KULeuven-MICAS/lagd-im/hw/rtl/analog_macro_wrap/CHANGELOG.md

## 0.1.0 - 2026-1-7
- Initial release of RTL and a testbench.

## 0.1.1 - 2026-1-12
- Add convertion for J/h from 2's complemented format to specific format (can be turn off).
- Remove signal *synchronizer_mode_i* as it is not useful.
- Add signal *wbl_floating_o* and *spin_feedback_o* which are newly required by the analog macro.
- Spread spin output to the analog macro in WBL. Its location is configued by a new parameter *SPIN_WBL_OFFSET*.
- Move the synchronization starting timing to be one cycle earlier.
- Add isolation AND gate in analog_tx if SYN=1.

## 0.1.2 - 2026-1-27
- Add debugging submodules for testing J/h writing/reading and spin writing/computing/reading.
- Add wwl_vdd_i and wwl_vread_i as new configurable parameters.
- Add debug_dt_configure_enable_i and debug_spin_configure_enable_i as new configuration enable signals for debug-related submodules.
- Add standard synchronization cells in analog_tx if SYN=1.
