KULeuven-MICAS/lagd-im/hw/rtl/digital_macro/CHANGELOG.md

## 0.1.0 - 2026-1-12
- Initial release of RTL and a testbench.
