KULeuven-MICAS/lagd-im/hw/rtl/flip_manager/CHANGELOG.md

## 0.1.0 - 2025-12-2
- Initial release of RTL and a testbench.
- The latency is 3 cycles.
- Configurability: depth of the spin fifo can be changed.
