KULeuven-MICAS/lagd-im/hw/tb/models/galena/galena.sv

// Copyright 2025 KU Leuven.
// Licensed under the Apache License, Version 2.0, see LICENSE for details.
// SPDX-License-Identifier: Apache-2.0
//
// Author: Jiacong Sun <jiacong.sun@kuleuven.be>

// Behavior model for galena

`timescale 1ns / 1ps

`ifndef PROJECT_ROOT
`define PROJECT_ROOT "../../"
`endif

`ifndef STATE_OUT_FILE_1
`define STATE_OUT_FILE_1 {`PROJECT_ROOT, "sw/tests/data/default/states_out_1"} // relative to hw/tb/
`endif

`ifndef STATE_OUT_FILE_2
`define STATE_OUT_FILE_2 {`PROJECT_ROOT, "sw/tests/data/default/states_out_2"} // relative to hw/tb/
`endif

`ifndef VERBOSE
`define VERBOSE 0
`endif

import galena_pkg::*;

`include "lagd_platform.svh"

module galena #(
) (

    // --- Analog pins ----
    inout j_vup_aio  ,  // not used in the behavior model, but included for completeness
    inout j_vdn_aio  ,  // not used in the behavior model, but included for completeness
    inout h_vup_aio  ,  // not used in the behavior model, but included for completeness
    inout h_vdn_aio  ,  // not used in the behavior model, but included for completeness
    inout vread_aio  ,  // not used in the behavior model, but included for completeness

    // --- Digital pins ---
    input [WBL_WIDTH-1:0] wbl_i,
    input [WBL_WIDTH-1:0] wblb_i, // not used in the behavior model, but included for completeness
    input [WBL_WIDTH-1:0] wbl_floating_i,

    input [WWL_WIDTH-1:0] wwl_i,
    input [WWL_WIDTH-1:0] wwl_vdd_i,
    input [WWL_WIDTH-1:0] wwl_vread_i,

    input [NUM_SPIN-1:0] write_spin_i,
    input [NUM_SPIN-1:0] feedback_i,

    output logic [WBL_WIDTH-1:0] wbl_read_o,
    output logic [WBL_WIDTH-1:0] wblb_read_o,
    output logic [NUM_SPIN-1:0] bct_read_o
);
    // Internal signals
    logic [WWL_WIDTH-1:0] [WBL_WIDTH-1:0] data_array;
    logic [NUM_SPIN-1:0] spin_cache;
    logic [SPIN_ICON_DEPTH-1:0] [NUM_SPIN-1:0] state_out;
    logic [$clog2(SPIN_ICON_DEPTH)-1:0] j = 0;
    real spin_delay = 0;

    // ========================================================================
    // BEHAVIOR MODEL
    // ========================================================================
    assign wblb_read_o = ~wbl_read_o;

    // Data writing
    generate
        for (genvar i = 0; i < WWL_WIDTH; i++) begin: data_writing
            always_ff @(posedge wwl_i[i]) begin
                if (wbl_floating_i == {WBL_WIDTH{1'b1}}) begin
                    data_array[i] <= wbl_i;
                    if (`VERBOSE) begin
                        $info("[Time: %0t] Data is written to data_array[%0d]: 'h%h", $time, i, wbl_i);
                    end
                end
            end
        end
    endgenerate

    // Data reading
    always_comb begin
        wbl_read_o = {WBL_WIDTH{1'bx}};
        for (int i = 0; i < WWL_WIDTH; i++) begin
            if (wwl_i[i]) begin
                if (wbl_floating_i == {WBL_WIDTH{1'b0}}) begin
                    wbl_read_o = data_array[i];
                end else begin
                    wbl_read_o = {WBL_WIDTH{1'bx}};
                end
            end
        end
    end

    // Spin intenal cache behavior
    generate
        if (DATA_FROM_FILE) begin
            // The state files are selected at run time, per core: this instance derives its core
            // index from its own hierarchical path (the gen_cores loop index in lagd_soc), so the
            // RTL instantiation stays identical to the real macro.
            // Priority: +CORE<n>_STATE_OUT_FILE_x, then +STATE_OUT_FILE_x, then `STATE_OUT_FILE_x.
            int core_id;
            string state_out_file_1;
            string state_out_file_2;
            initial begin
                core_id = hier_loop_index($sformatf("%m"));
                state_out_file_1 = `STATE_OUT_FILE_1;
                state_out_file_2 = `STATE_OUT_FILE_2;
                void'($value$plusargs("STATE_OUT_FILE_1=%s", state_out_file_1));
                void'($value$plusargs("STATE_OUT_FILE_2=%s", state_out_file_2));
                void'($value$plusargs($sformatf("CORE%0d_STATE_OUT_FILE_1=%%s", core_id),
                                      state_out_file_1));
                void'($value$plusargs($sformatf("CORE%0d_STATE_OUT_FILE_2=%%s", core_id),
                                      state_out_file_2));
                $display("[Time: %0t] %m is the analog macro of core %0d", $time, core_id);
                state_out = load_state_out_ref(state_out_file_1, state_out_file_2);
            end
            always_ff @(posedge &write_spin_i) begin // the behavior model assumes write_spin_i is all-one or all-zero
                spin_cache <= state_out[j];
                if (`VERBOSE) begin
                    $info("[Time: %0t] Spin initial cache is updated from state_out[%0d]: 'h%h", $time, j, state_out[j]);
                end
                j <= (j + 1) % SPIN_ICON_DEPTH;
            end
        end else begin
            always_ff @(posedge &write_spin_i) begin // the behavior model assumes write_spin_i is all-one or all-zero
                for (int i = 0; i < NUM_SPIN; i++) begin
                    spin_cache[i] <= wbl_i[BIT_DATA*i + SPIN_WBL_OFFSET];
                end
                if (`VERBOSE) begin
                    $info("[Time: %0t] Spin internal cache is updated from wbl_i: 'h%h", $time, wbl_i);
                end
            end
        end
    endgenerate

    // Spin readout behavior
    generate
        for (genvar i = 0; i < NUM_SPIN; i++) begin: spin_readout
            initial begin
                forever begin
                    @(posedge feedback_i[i]); // Wait for rising edge of feedback_i[i]
                    spin_delay = $urandom_range(SPIN_DELAY_MIN*1000, SPIN_DELAY_MAX*1000) / 1000.0; // random delay
                    #spin_delay;
                    bct_read_o[i] = spin_cache[i];
                    @(negedge feedback_i[i]); // Wait for falling edge of feedback_i[i]
                    bct_read_o[i] = 1'bx;
                end
            end
        end
    endgenerate

    // ========================================================================
    // CHECKS
    // ========================================================================
`ifndef TARGET_GALENA_NO_CHECKS
    `RUNTIME_ASSERT($time == 0 || $onehot0(wwl_i), $sformatf("wwl_i is not one-hot: 'h%h", wwl_i));

    // all-zero/one check on wbl_floating_i, wwl_vdd_i, wwl_vread_i, write_spin_i, feedback_i
    `RUNTIME_ASSERT($time == 0 || wbl_floating_i == 0 || wbl_floating_i == {WBL_WIDTH{1'b1}}, $sformatf("wbl_floating_i is not all-zero or all-one: 'h%h", wbl_floating_i));
    `RUNTIME_ASSERT($time == 0 || wwl_vdd_i      == 0 || wwl_vdd_i      == {WWL_WIDTH{1'b1}}, $sformatf("wwl_vdd_i is not all-zero or all-one: 'h%h",           wwl_vdd_i));
    `RUNTIME_ASSERT($time == 0 || wwl_vread_i    == 0 || wwl_vread_i    == {WWL_WIDTH{1'b1}}, $sformatf("wwl_vread_i is not all-zero or all-one: 'h%h",       wwl_vread_i));
    `RUNTIME_ASSERT($time == 0 || write_spin_i   == 0 || write_spin_i   == {NUM_SPIN {1'b1}}, $sformatf("write_spin_i is not all-zero or all-one: 'h%h",     write_spin_i));
    `RUNTIME_ASSERT($time == 0 || feedback_i     == 0 || feedback_i     == {NUM_SPIN {1'b1}}, $sformatf("feedback_i is not all-zero or all-one: 'h%h",         feedback_i));

    // check: wwl_vdd_i and wwl_vread_i cannot be both 1
    `RUNTIME_ASSERT($time == 0 || (wwl_vdd_i & wwl_vread_i) == 0, $sformatf("wwl_vdd_i and wwl_vread_i cannot be both 1: wwl_vdd_i: 'h%h, wwl_vread_i: 'h%h", wwl_vdd_i, wwl_vread_i));

    // check: wwl_i and write_spin_i cannot be both 1
    `RUNTIME_ASSERT($time == 0 || ($countones(wwl_i) == 0) || ($countones(write_spin_i) == 0), $sformatf("wwl_i and write_spin_i cannot be both 1: wwl_i: 'h%h, write_spin_i: 'h%h", wwl_i, write_spin_i));
`endif

endmodule
