KULeuven-MICAS/lagd-im/hw/rtl/flip_manager/flip_manager.sv

// Copyright 2025 KU Leuven.
// Licensed under the Apache License, Version 2.0, see LICENSE for details.
// SPDX-License-Identifier: Apache-2.0

// Author: Jiacong Sun <jiacong.sun@kuleuven.be>
//
// Flip manager
// Manages spin configuration, buffering, energy-maintenance and flip engine interface.
// Coordinates three sub-modules: energy_fifo_maintainer, spin_fifo_maintainer and flip_engine.
//
// Parameters:
// - NUM_SPIN: width of a spin vector (number of spins per word)
// - SPIN_DEPTH: depth (entries) of internal spin FIFOs
// - ENERGY_TOTAL_BIT: bit-width of the total energy value
// - FLIP_ICON_DEPTH: depth of flip icon memory
// - FLIP_ICON_ADDR_DEPTH: address width for flip icon memory (usually $clog2(FLIP_ICON_DEPTH))
//
// Notes:
// - This module arbitrates between configuration-driven pushes and energy-driven pushes into the spin FIFO.

`include "common_cells/registers.svh"

module flip_manager #(
    parameter int NUM_SPIN = 256,
    parameter int SPIN_DEPTH = 2,
    parameter int ENERGY_TOTAL_BIT = 32,
    parameter int FLIP_ICON_DEPTH = 1024,
    // Do not override
    parameter int FLIP_ICON_ADDR_DEPTH = $clog2(FLIP_ICON_DEPTH)
)(
    input logic clk_i,
    input logic rst_ni,
    input logic en_i,
    input logic flush_i,
    input logic en_comparison_i,

    input logic cmpt_en_i,
    output logic cmpt_idle_o,
    input logic host_readout_i,

    input logic spin_configure_valid_i,
    input logic [NUM_SPIN-1:0] spin_configure_i,
    input logic spin_configure_push_none_i,
    output logic spin_configure_ready_o,

    output logic spin_pop_valid_o,
    output logic [NUM_SPIN-1:0] spin_pop_o,
    input logic spin_pop_ready_i,

    input logic energy_valid_i,
    output logic energy_ready_o,
    input logic signed [ENERGY_TOTAL_BIT-1:0] energy_i,
    input logic [NUM_SPIN-1:0] spin_i,

    output logic flip_ren_o,
    output logic [FLIP_ICON_ADDR_DEPTH+1-1:0] flip_raddr_o,
    input logic [FLIP_ICON_ADDR_DEPTH+1-1:0] icon_last_raddr_plus_one_i,
    input logic [NUM_SPIN-1:0] flip_rdata_i,

    input logic flip_disable_i,

    // for debugging purposes
    output logic energy_fifo_update_o,
    output logic spin_fifo_update_o,
    output logic signed [SPIN_DEPTH-1:0] [ENERGY_TOTAL_BIT-1:0] energy_fifo_o,
    output logic [SPIN_DEPTH-1:0] [NUM_SPIN-1:0] spin_fifo_o,
    // for measurement purposes
    input logic infinite_icon_loop_en_i
);
    // Internal signals
    logic cmpt_busy;
    logic spin_pop_valid_p;
    logic [NUM_SPIN-1:0] spin_pop_p;
    logic spin_pop_ready_p;
    logic spin_maintainer_push_valid;
    logic [NUM_SPIN-1:0] spin_maintainer_income;
    logic spin_maintainer_push_from_en;
    logic [NUM_SPIN-1:0] spin_maintainer_income_from_en;
    logic spin_maintainer_push_none_from_en;
    logic spin_maintainer_push_ready;
    logic spin_maintainer_push_none;
    logic cmpt_stop_reg;
    logic icon_finish;
    logic fifo_full_and_idle_comb;
    logic fifo_full_and_idle_reg;

    logic spin_pop_handshake;
    logic energy_handshake;
    logic spin_fifo_push_handshake;
    logic energy_handshake_dly1;
    logic spin_fifo_push_handshake_dly1;

    // control logic
    assign spin_configure_ready_o = spin_maintainer_push_ready & cmpt_idle_o;
    assign spin_maintainer_push_valid = cmpt_busy ? spin_maintainer_push_from_en : spin_configure_valid_i;
    assign spin_maintainer_income = cmpt_busy ? spin_maintainer_income_from_en : spin_configure_i;
    assign spin_maintainer_push_none = cmpt_busy ? spin_maintainer_push_none_from_en : spin_configure_push_none_i;

    assign spin_pop_handshake = spin_pop_valid_o & spin_pop_ready_i;
    assign energy_handshake = energy_valid_i & energy_ready_o & (~cmpt_idle_o);
    assign spin_fifo_push_handshake = spin_maintainer_push_valid & spin_maintainer_push_ready;

    assign cmpt_idle_o = ~cmpt_busy;

    // Note: when energy_fifo_update_o is high, it means a new energy value has ALREADY been pushed into the energy FIFO
    assign energy_fifo_update_o = energy_handshake_dly1;
    assign spin_fifo_update_o = spin_fifo_push_handshake_dly1;

    `FFL(energy_handshake_dly1, energy_handshake, en_i, 1'b0, clk_i, rst_ni);
    `FFL(spin_fifo_push_handshake_dly1, spin_fifo_push_handshake, en_i, 1'b0, clk_i, rst_ni);

    // Instantiate energy maintainer
    energy_fifo_maintainer #(
        .NUM_SPIN(NUM_SPIN),
        .SPIN_DEPTH(SPIN_DEPTH),
        .ENERGY_TOTAL_BIT(ENERGY_TOTAL_BIT)
    ) u_energy_fifo_maintainer (
        .clk_i(clk_i),
        .rst_ni(rst_ni),
        .en_i(en_i),
        .flush_i(flush_i),
        .en_comparison_i(en_comparison_i),
        .spin_valid_o(spin_maintainer_push_from_en),
        .spin_o(spin_maintainer_income_from_en),
        .spin_push_none_o(spin_maintainer_push_none_from_en),
        .spin_ready_i(spin_maintainer_push_ready),
        .energy_valid_i(energy_valid_i),
        .energy_ready_o(energy_ready_o),
        .spin_i(spin_i),
        .energy_i(energy_i),
        .debug_fifo_usage_o(),
        .energy_fifo_o(energy_fifo_o)
    );

    // Instantiate spin FIFO maintainer
    spin_fifo_maintainer #(
        .SPIN_DEPTH(SPIN_DEPTH),
        .NUM_SPIN(NUM_SPIN)
    ) u_spin_fifo_maintainer (
        .clk_i(clk_i),
        .rst_ni(rst_ni),
        .en_i(en_i),
        .flush_i(flush_i),
        .cmpt_en_i(cmpt_en_i),
        .icon_finish_i(icon_finish),
        .host_readout_i(host_readout_i),
        .spin_push_valid_i(spin_maintainer_push_valid),
        .spin_push_i(spin_maintainer_income),
        .spin_push_none_i(spin_maintainer_push_none),
        .spin_push_ready_o(spin_maintainer_push_ready),
        .spin_pop_valid_o(spin_pop_valid_p),
        .spin_pop_o(spin_pop_p),
        .spin_pop_ready_i(spin_pop_ready_p),
        .cmpt_busy_o(cmpt_busy),
        .spin_fifo_o(spin_fifo_o),
        .debug_fifo_usage_o()
    );

    // Instantiate flip engine
    flip_engine #(
        .SPIN_DEPTH(SPIN_DEPTH),
        .NUM_SPIN(NUM_SPIN),
        .FLIP_ICON_DEPTH(FLIP_ICON_DEPTH),
        .FLIP_ICON_ADDR_DEPTH(FLIP_ICON_ADDR_DEPTH)
    ) u_flip_engine (
        .clk_i(clk_i),
        .rst_ni(rst_ni),
        .en_i(1'b1),
        .cmpt_en_i(cmpt_en_i),
        .flush_i(flush_i),
        .prev_spin_valid_i(spin_pop_valid_p),
        .prev_spin_i(spin_pop_p),
        .prev_spin_ready_o(spin_pop_ready_p),
        .flipped_spin_ready_i(spin_pop_ready_i),
        .flipped_spin_o(spin_pop_o),
        .flipped_spin_valid_o(spin_pop_valid_o),
        .flip_ren_o(flip_ren_o),
        .flip_raddr_o(flip_raddr_o),
        .flip_rdata_i(flip_rdata_i),
        .icon_last_raddr_plus_one_i(icon_last_raddr_plus_one_i),
        .icon_finish_o(icon_finish),
        .flip_disable_i(flip_disable_i),
        .infinite_icon_loop_en_i(infinite_icon_loop_en_i)
    );

endmodule
