KULeuven-MICAS/lagd-im/hw/rtl/analog_macro_wrap/analog_rx.sv

// Copyright 2025 KU Leuven.
// Licensed under the Apache License, Version 2.0, see LICENSE for details.
// SPDX-License-Identifier: Apache-2.0

// Author: Jiacong Sun <jiacong.sun@kuleuven.be>
//
// Analog RX module, which receives spin data from digital macro and sends to analog macro.

`include "common_cells/registers.svh"

module analog_rx #(
    parameter integer NUM_SPIN = 256,
    parameter integer COUNTER_BITWIDTH = 8
)(
    input logic clk_i,
    input logic rst_ni,
    input logic en_i,
    // config interface
    input  logic rx_configure_enable_i,
    input  logic [COUNTER_BITWIDTH-1:0] cycle_per_spin_write_i,
    input  logic [NUM_SPIN-1:0] spin_wwl_strobe_i,
    input  logic [NUM_SPIN-1:0] spin_feedback_i,
    input  logic [COUNTER_BITWIDTH-1:0] cycle_per_spin_compute_i,
    // spin interface: rx <-> digital
    input  logic spin_pop_valid_i,
    output logic spin_pop_ready_o,
    input  logic [NUM_SPIN-1:0] spin_pop_i,
    input  logic analog_macro_idle_i,
    // spin interface: tx -> analog macro
    output logic [NUM_SPIN-1:0] spin_wwl_o,
    output logic [NUM_SPIN-1:0] spin_feedback_o,
    output logic [NUM_SPIN-1:0] wbl_o,
    // status
    output logic analog_rx_idle_o,
    output logic analog_macro_cmpt_finish_o
);
    // Internal signals
    logic spin_pop_handshake;
    logic [NUM_SPIN-1:0] spin_pop_comb;
    logic [NUM_SPIN-1:0] spin_wwl_strobe_reg;
    logic [NUM_SPIN-1:0] spin_feedback_reg;
    logic [NUM_SPIN-1:0] spin_wwl_comb;
    logic rx_busy;
    logic spin_pop_cond;
    logic spin_pop_ready_reset_cond;
    logic spin_wwl_reset_cond;
    logic config_cond;
    logic wwl_high_counter_en, cmpt_counter_en;
    logic wwl_high_counter_en_cond;
    logic wwl_high_counter_maxed, cmpt_counter_maxed;
    logic wwl_high_counter_overflow, cmpt_counter_overflow;
    logic [COUNTER_BITWIDTH-1:0] wwl_high_counter_q, cmpt_counter_q;

    assign analog_rx_idle_o = !rx_busy;
    assign spin_pop_handshake = spin_pop_valid_i & spin_pop_ready_o;
    assign spin_pop_comb = spin_pop_handshake ? spin_pop_i : 'd0;

    assign spin_pop_cond = en_i & spin_pop_handshake;
    assign spin_pop_ready_reset_cond = !en_i | analog_macro_idle_i;
    assign spin_wwl_reset_cond = en_i & wwl_high_counter_maxed;
    assign analog_macro_cmpt_finish_o = en_i & cmpt_counter_maxed;
    assign config_cond = en_i & rx_configure_enable_i;
    assign wwl_high_counter_en_cond = en_i & spin_pop_handshake;

    `FFLARNC(spin_pop_ready_o, 1'b0, spin_pop_cond, spin_pop_ready_reset_cond, 1'b1, clk_i, rst_ni)
    `FFL(wbl_o, spin_pop_comb, spin_pop_cond, 'd0, clk_i, rst_ni)
    `FFLARNC(spin_wwl_o, spin_wwl_strobe_reg, spin_pop_cond, spin_wwl_reset_cond, 'd0, clk_i, rst_ni)
    `FFLARNC(spin_feedback_o, spin_feedback_reg, spin_wwl_reset_cond, cmpt_counter_maxed, 'd0, clk_i, rst_ni)
    `FFLARNC(wwl_high_counter_en, 1'b1, wwl_high_counter_en_cond, wwl_high_counter_maxed, 1'b0, clk_i, rst_ni)
    `FFLARNC(cmpt_counter_en, 1'b1, spin_wwl_reset_cond, cmpt_counter_maxed, 1'b0, clk_i, rst_ni)

    // configure registers
    `FFLARNC(rx_busy, 1'b1, spin_pop_cond, spin_wwl_reset_cond, 1'b0, clk_i, rst_ni)
    `FFL(spin_wwl_strobe_reg, spin_wwl_strobe_i, config_cond, 'd0, clk_i, rst_ni)
    `FFL(spin_feedback_reg, spin_feedback_i, config_cond, 'd0, clk_i, rst_ni)

    step_counter #(
        .COUNTER_BITWIDTH (COUNTER_BITWIDTH),
        .PARALLELISM (1)
    ) i_wwl_high_counter (
        .clk_i (clk_i),
        .rst_ni (rst_ni),
        .en_i (en_i),
        .load_i (rx_configure_enable_i),
        .d_i (cycle_per_spin_write_i),
        .recount_en_i (spin_pop_handshake),
        .step_en_i (wwl_high_counter_en),
        .q_o (wwl_high_counter_q),
        .maxed_o (wwl_high_counter_maxed),
        .overflow_o (wwl_high_counter_overflow)
    );

    step_counter #(
        .COUNTER_BITWIDTH (COUNTER_BITWIDTH),
        .PARALLELISM (1)
    ) i_cmpt_counter (
        .clk_i (clk_i),
        .rst_ni (rst_ni),
        .en_i (en_i),
        .load_i (rx_configure_enable_i),
        .d_i (cycle_per_spin_compute_i),
        .recount_en_i (spin_pop_handshake),
        .step_en_i (cmpt_counter_en),
        .q_o (cmpt_counter_q),
        .maxed_o (cmpt_counter_maxed),
        .overflow_o (cmpt_counter_overflow)
    );

endmodule
