KULeuven-MICAS/lagd-im/sw/tests/lagd_scompute_debug.spm.c

// Copyright 2025 KU Leuven.
// Licensed under the Apache License, Version 2.0, see LICENSE for details.
// SPDX-License-Identifier: Apache-2.0
// Author: Jiacong Sun <jiacong.sun@kuleuven.be>

#ifndef CORE_TESTED
#define CORE_TESTED 0
#endif

#ifndef VERIFICATION_TEST
#define VERIFICATION_TEST 0
#endif

#ifndef MAX_SAMPLES
#define MAX_SAMPLES 2048
#endif

// cheshire headers
#include "regs/cheshire.h"
#include "dif/clint.h"
#include "dif/uart.h"
#include "dif/dma.h"
#include "params.h"
#include "util.h"
#include "printf.h"
// lagd headers
// lagd_scompute.h must come before lagd_common.h
#include "lagd_scompute.h"
#include "lagd_common.h"
#include "lagd_debug_load.h"

int main(void) {
    static uint32_t log_buf_energy[MAX_SAMPLES];
    static uint32_t log_buf_cnt[MAX_SAMPLES];
    // UART init
    // uint64_t t0 = clint_get_mtime();
    uint32_t rtc_freq = *reg32(&__base_regs, CHESHIRE_RTC_FREQ_REG_OFFSET);
    uint64_t reset_freq = clint_get_core_freq(rtc_freq, 2500);
    uart_init(&__base_uart, reset_freq, __BOOT_BAUDRATE);

    // register configuration
    lagd_configure_initial_spins(CORE_TESTED);
    lagd_configure_cmpt_max_num(CORE_TESTED);
    lagd_configure_counters(CORE_TESTED);
    lagd_configure_wwl_vdd_cfg(CORE_TESTED);
    lagd_configure_wwl_vread_cfg(CORE_TESTED);
    lagd_configure_spin_wwl_strobe(CORE_TESTED);
    lagd_configure_spin_feedback(CORE_TESTED);
    lagd_configure_h_rdata(CORE_TESTED);
    lagd_configure_global_cfg_1(CORE_TESTED);
    lagd_configure_global_cfg_2(CORE_TESTED);
    // clear config valid
    lagd_clear_config_valid(CORE_TESTED);
    printf("Debug J/h loading, core %u, real-chip signs and reversed J rows\r\n",
           (unsigned)CORE_TESTED);
    if (debug_load_jh(CORE_TESTED)) {
        printf("J/h loading FAIL; computation skipped\r\n");
        uart_write_flush(&__base_uart);
        return 1;
    }
    printf("J/h write sequence done (readback unsupported)\r\n");

    // check initial spin
    lagd_print_spin_fifo_data(CORE_TESTED);
    // start computation
    lagd_enable_energy_monitor_fifo(CORE_TESTED);
    lagd_enable_computation(CORE_TESTED);
    unsigned log_cnt_energy;
    unsigned log_cnt_cycle;
    log_cnt_energy = lagd_monitor_energy_fifo_dbg_0(CORE_TESTED, MAX_SAMPLES, log_buf_energy);
    log_cnt_cycle = lagd_monitor_cycle_per_iteration(CORE_TESTED, MAX_SAMPLES, log_buf_cnt);
    // wait for computation to finish
    lagd_wait_for_computation_done(CORE_TESTED);

    // check final output
    if (VERIFICATION_TEST) {
        int fail = lagd_check_spin_fifo_data(CORE_TESTED);
        if (fail == 0) {
            printf("PASS\r\n");
        } else {
            printf("FAIL\r\n");
        }
        uart_write_flush(&__base_uart);
        return fail;
    } else {
        // print final output
        lagd_print_energy_fifo_data(CORE_TESTED);

        // print energy monitor fifo debug register log
        lagd_print_energy_fifo_dbg(CORE_TESTED, log_cnt_energy, log_buf_energy);
        // print performance counter log
        lagd_print_cycle_per_iteration(CORE_TESTED, log_cnt_cycle, log_buf_cnt);

        lagd_print_spin_fifo_data(CORE_TESTED);

        printf("=== DONE ===\r\n");
        uart_write_flush(&__base_uart);
        return 0;
    }
}
