KULeuven-MICAS/lagd-im/hw/unit_tests/analog_macro_wrap/tb_analog_macro_wrap.sv

// Copyright 2025 KU Leuven.
// Licensed under the Apache License, Version 2.0, see LICENSE for details.
// SPDX-License-Identifier: Apache-2.0
// Author: Jiacong Sun <jiacong.sun@kuleuven.be>

`timescale 1ns / 1ps

`ifndef DBG
`define DBG 0
`endif

`ifndef VCD_FILE
`define VCD_FILE "tb_analog_macro_wrap.vcd"
`endif

module tb_analog_macro_wrap;

    // module parameters
    localparam int NUM_SPIN = 256; // number of spins
    localparam int BITDATA = 4; // bit width of J and h, sfc
    localparam int COUNTER_BITWIDTH = 16;
    localparam int SYNCHRONIZER_PIPE_DEPTH = 3;
    localparam int DEBUG_WADDR_UP_LIMIT = 1024; // same as memory word depth
    localparam int DEBUG_WADDR_WIDTH = $clog2(DEBUG_WADDR_UP_LIMIT); // width of debug spin read address
    localparam int PARALLELISM = 4; // number of parallel data in J memory
    localparam int SPIN_WBL_OFFSET = 0; // offset of spin wbl in the wbl data from digital macro (must less than BITDATA)
    localparam int J_ADDRESS_WIDTH = $clog2(NUM_SPIN / PARALLELISM);
    localparam int OnloadingTestNum = 10_000; // number of onloading tests
    localparam int CmptTestNum = 10_000; // number of compute tests
    localparam int DebugTestNum = 100; // number of debug tests

    // testbench parameters
    localparam int CLKCYCLE = 2;
    logic RANDOM_DATA = 1; // random J and h if set to 1, otherwise use FIXED_DATA
    logic signed [BITDATA-1:0] FIXED_DATA = -1; // fixed J/h if RANDOM_DATA is 0

    // dut run-time configuration
    localparam int CyclePerWwlHigh = 3;
    localparam int CyclePerWwlLow = 3;
    localparam int CyclePerSpinWrite = 3;
    localparam int CyclePerSpinCompute = 5;
    localparam int CyclePerSpinRead = 6;
    localparam int DebugSpinReadNum = 8;
    localparam int SynchronizerPipeNum = 3;
    localparam int SpinWwlStrobe = {(NUM_SPIN){1'b1}}; // all spins enabled
    localparam int SpinFeedback = {(NUM_SPIN){1'b1}}; // all spins in feedback mode

    // testbench internal signals
    logic clk_i;
    logic rst_ni;
    logic en_i;
    logic analog_wrap_configure_enable_i;
    logic debug_dt_configure_enable_i;
    logic [COUNTER_BITWIDTH-1:0] cfg_trans_num_i;
    logic [COUNTER_BITWIDTH-1:0] cycle_per_wwl_high_i, cycle_per_wwl_low_i;
    logic [COUNTER_BITWIDTH-1:0] cycle_per_spin_write_i;
    logic [COUNTER_BITWIDTH-1:0] cycle_per_spin_compute_i;
    logic bypass_data_conversion_i;
    logic [NUM_SPIN-1:0] spin_wwl_strobe_i;
    logic [NUM_SPIN-1:0] spin_feedback_i;
    logic [$clog2(SYNCHRONIZER_PIPE_DEPTH)-1:0] synchronizer_pipe_num_i;
    logic [$clog2(SYNCHRONIZER_PIPE_DEPTH)-1:0] synchronizer_wbl_pipe_num_i;
    logic [NUM_SPIN*BITDATA-1:0] wbl_floating_i;
    logic dt_cfg_enable_i;
    logic j_mem_ren_o;
    logic [J_ADDRESS_WIDTH-1:0] j_raddr_o;
    logic [NUM_SPIN*BITDATA*PARALLELISM-1:0] j_rdata_i, j_rdata_latched;
    logic h_ren_o;
    logic [NUM_SPIN*BITDATA-1:0] h_rdata_i, hbias_in_reg;
    logic [NUM_SPIN-1:0] j_one_hot_wwl_o;
    logic h_wwl_o;
    logic [NUM_SPIN*BITDATA-1:0] wbl_copy, wbl_floating_o;
    logic [NUM_SPIN*BITDATA-1:0] wbl_o, wblb_o;
    logic [NUM_SPIN*BITDATA-1:0] wbl_read_i, wblb_read_i;
    logic spin_pop_valid_i;
    logic spin_pop_ready_o;
    logic spin_pop_handshake;
    logic spin_push_handshake;
    logic [NUM_SPIN-1:0] spin_pop_i, spin_pop_ref;
    logic spin_pop_ref_valid;
    logic [NUM_SPIN-1:0] spin_wwl_o;
    logic [NUM_SPIN-1:0] spin_feedback_o;
    logic [NUM_SPIN*BITDATA-1:0] wbl_i; // used only in testbench reference model
    logic [NUM_SPIN-1:0] spin_analog_i;
    logic spin_valid_o;
    logic spin_ready_i;
    logic [NUM_SPIN-1:0] spin_o;
    logic dt_cfg_idle_o;
    logic analog_rx_idle_o;
    logic analog_tx_idle_o;
    logic [COUNTER_BITWIDTH-1:0] debug_cycle_per_spin_read_i;
    logic [COUNTER_BITWIDTH-1:0] debug_spin_read_num_i;
    // debugging interface
    logic debug_j_write_en_i;
    logic debug_j_read_en_i;
    logic [NUM_SPIN-1:0] debug_j_one_hot_wwl_i;
    logic [$clog2(NUM_SPIN)-1:0] debug_j_analog_waddr, debug_j_analog_raddr;
    logic debug_h_wwl_i;
    logic [NUM_SPIN*BITDATA-1:0] debug_wbl_i;
    logic debug_spin_write_en_i;
    logic debug_spin_read_en_i;
    logic debug_spin_valid_o;
    logic [DEBUG_WADDR_WIDTH-1:0] debug_spin_waddr_o;
    logic [NUM_SPIN-1:0] debug_spin_o;
    logic debug_wbl_read_data_valid_o;
    logic [NUM_SPIN*BITDATA-1:0] debug_wbl_read_data_o, debug_wblb_read_data_o;
    logic debug_analog_dt_w_idle_o, debug_analog_dt_r_idle_o;
    logic [NUM_SPIN:0] wwl_vdd_i;
    logic [NUM_SPIN:0] wwl_vread_i;
    logic [NUM_SPIN:0] wwl_vdd_o;
    logic [NUM_SPIN:0] wwl_vread_o;

    logic config_aw_done;
    logic config_galena_done;
    logic debug_galena_done;
    logic debug_galena_dt_done;
    logic debug_galena_spin_done;
    logic [NUM_SPIN/PARALLELISM-1:0][NUM_SPIN*BITDATA*PARALLELISM-1:0] weights_in_mem;
    logic [NUM_SPIN-1:0][NUM_SPIN*BITDATA-1:0] weights_in_mem_ordered, weights_analog;
    logic [NUM_SPIN*BITDATA-1:0] hbias_analog;
    logic [ $clog2(NUM_SPIN / PARALLELISM)-1 : 0 ] j_raddr_ref;
    integer galena_addr_idx;
    integer dt_write_cycle_cnt_j, dt_write_cycle_cnt_hbias;
    integer onloading_test_idx;
    integer cmpt_test_idx;
    integer galena_spin_write_cycle_cnt;
    integer config_test_correct_cnt_j, config_test_correct_cnt_h;
    integer cmpt_correct_cnt, cmpt_error_cnt;
    integer spin_pop_handshake_cnt;
    logic debug_j_write_en_dly1, debug_j_read_en_dly1, debug_spin_write_en_dly1, debug_spin_read_en_dly1, debug_spin_compute_en_dly1;
    logic debug_j_write_en_posedge, debug_j_read_en_posedge, debug_spin_write_en_posedge, debug_spin_read_en_posedge, debug_spin_compute_en_posedge;
    integer debug_test_idx;
    integer debug_dt_write_cycle_cnt_j;
    logic debug_spin_compute_en_i;
    logic debug_spin_w_idle_o, debug_spin_cmpt_idle_o, debug_spin_r_idle_o;
    logic debug_spin_configure_enable_i;
    logic [BITDATA-1:0] temp_debug_wbl_data;
    logic [NUM_SPIN-1:0] debug_spin_read_ref;
    integer debug_spin_read_cycle_cnt;
    integer debug_spin_read_num_ref_cnt;

    assign spin_pop_handshake = spin_pop_valid_i & spin_pop_ready_o;
    assign spin_push_handshake = spin_valid_o & spin_ready_i;

    assign debug_j_write_en_posedge = debug_j_write_en_i & (~debug_j_write_en_dly1);
    assign debug_j_read_en_posedge = debug_j_read_en_i & (~debug_j_read_en_dly1);
    assign debug_spin_write_en_posedge = debug_spin_write_en_i & (~debug_spin_write_en_dly1);
    assign debug_spin_read_en_posedge = debug_spin_read_en_i & (~debug_spin_read_en_dly1);
    assign debug_spin_compute_en_posedge = debug_spin_compute_en_i & (~debug_spin_compute_en_dly1);
    assign debug_galena_done = debug_galena_dt_done & debug_galena_spin_done;

    always_comb begin
        for (int i=0; i < NUM_SPIN; i=i+1) begin
            spin_analog_i[i] = wbl_i[i*BITDATA + SPIN_WBL_OFFSET];
        end
    end

    initial begin
        en_i = 1;
        bypass_data_conversion_i = 0;
    end

    // Module instantiation
    analog_macro_wrap #(
        .NUM_SPIN(NUM_SPIN),
        .BITDATA(BITDATA),
        .PARALLELISM(PARALLELISM),
        .COUNTER_BITWIDTH(COUNTER_BITWIDTH),
        .SYNCHRONIZER_PIPEDEPTH(SYNCHRONIZER_PIPE_DEPTH),
        .SPIN_WBL_OFFSET(SPIN_WBL_OFFSET),
        .DEBUG_WADDR_UP_LIMIT(DEBUG_WADDR_UP_LIMIT)
    ) dut (
        .clk_i                             (clk_i                            ),
        .rst_ni                            (rst_ni                           ),
        .en_i                              (en_i                             ),
        .analog_wrap_configure_enable_i    (analog_wrap_configure_enable_i   ),
        .debug_dt_configure_enable_i       (debug_dt_configure_enable_i      ),
        .debug_spin_configure_enable_i     (debug_spin_configure_enable_i    ),
        .cfg_trans_num_i                   (cfg_trans_num_i                  ),
        .cycle_per_wwl_high_i              (cycle_per_wwl_high_i             ),
        .cycle_per_wwl_low_i               (cycle_per_wwl_low_i              ),
        .cycle_per_spin_write_i            (cycle_per_spin_write_i           ),
        .cycle_per_spin_compute_i          (cycle_per_spin_compute_i         ),
        .wwl_vdd_i                         (wwl_vdd_i                        ),
        .wwl_vread_i                       (wwl_vread_i                      ),
        .bypass_data_conversion_i          (bypass_data_conversion_i         ),
        .spin_wwl_strobe_i                 (spin_wwl_strobe_i                ),
        .spin_feedback_i                   (spin_feedback_i                  ),
        .synchronizer_pipe_num_i           (synchronizer_pipe_num_i          ),
        .synchronizer_wbl_pipe_num_i       (synchronizer_wbl_pipe_num_i      ),
        .debug_cycle_per_spin_read_i       (debug_cycle_per_spin_read_i      ),
        .debug_spin_read_num_i             (debug_spin_read_num_i            ),
        .dt_cfg_enable_i                   (dt_cfg_enable_i                  ),
        .j_mem_ren_o                       (j_mem_ren_o                      ),
        .j_raddr_o                         (j_raddr_o                        ),
        .j_rdata_i                         (j_rdata_i                        ),
        .h_ren_o                           (h_ren_o                          ),
        .h_rdata_i                         (h_rdata_i                        ),
        .j_one_hot_wwl_o                   (j_one_hot_wwl_o                  ),
        .h_wwl_o                           (h_wwl_o                          ),
        .wbl_o                             (wbl_o                            ),
        .wblb_o                            (wblb_o                           ),
        .wbl_read_i                        (wbl_read_i                       ),
        .wblb_read_i                       (wblb_read_i                      ),
        .wbl_floating_o                    (wbl_floating_o                   ),
        .wwl_vdd_o                         (wwl_vdd_o                        ),
        .wwl_vread_o                       (wwl_vread_o                      ),
        .spin_pop_valid_i                  (spin_pop_valid_i                 ),
        .spin_pop_ready_o                  (spin_pop_ready_o                 ),
        .spin_pop_i                        (spin_pop_i                       ),
        .spin_wwl_o                        (spin_wwl_o                       ),
        .spin_analog_i                     (spin_analog_i                    ),
        .spin_feedback_o                   (spin_feedback_o                  ),
        .spin_valid_o                      (spin_valid_o                     ),
        .spin_ready_i                      (spin_ready_i                     ),
        .spin_o                            (spin_o                           ),
        // debugging interface: inputs
        .debug_j_write_en_i                (debug_j_write_en_i               ),
        .debug_j_read_en_i                 (debug_j_read_en_i                ),
        .debug_j_one_hot_wwl_i             (debug_j_one_hot_wwl_i            ),
        .debug_h_wwl_i                     (debug_h_wwl_i                    ),
        .debug_wbl_i                       (debug_wbl_i                      ),
        .wbl_floating_i                    (wbl_floating_i                   ),
        .debug_spin_write_en_i             (debug_spin_write_en_i            ),
        .debug_spin_read_en_i              (debug_spin_read_en_i             ),
        .debug_spin_compute_en_i           (debug_spin_compute_en_i          ),
        // debugging interface: outputs
        .debug_dt_w_idle_o                 (debug_analog_dt_w_idle_o         ),
        .debug_dt_r_idle_o                 (debug_analog_dt_r_idle_o         ),
        .debug_spin_w_idle_o               (debug_spin_w_idle_o              ),
        .debug_spin_cmpt_idle_o            (debug_spin_cmpt_idle_o           ),
        .debug_spin_r_idle_o               (debug_spin_r_idle_o              ),
        .debug_wbl_read_data_valid_o       (debug_wbl_read_data_valid_o      ),
        .debug_wbl_read_data_o             (debug_wbl_read_data_o            ),
        .debug_wblb_read_data_o            (debug_wblb_read_data_o           ),
        .debug_spin_valid_o                (debug_spin_valid_o               ),
        .debug_spin_waddr_o                (debug_spin_waddr_o               ),
        .debug_spin_o                      (debug_spin_o                     ),
        // status
        .dt_cfg_idle_o                     (dt_cfg_idle_o                    ),
        .analog_rx_idle_o                  (analog_rx_idle_o                 ),
        .analog_tx_idle_o                  (analog_tx_idle_o                 )
    );

    // Clock generation
    initial begin
        clk_i = 0;
        forever #(CLKCYCLE/2) clk_i = ~clk_i;
    end

    // Reset generation
    initial begin
        rst_ni = 0;
        #(5 * CLKCYCLE);
        rst_ni = 1;
        #(5 * CLKCYCLE);
        en_i = 1;
    end

    // Run tests
    initial begin
        if (`DBG) begin
            $display("Debug mode enabled. Running with detailed output.");
            $dumpfile(`VCD_FILE);
            $dumpvars(4, tb_analog_macro_wrap); // Dump all variables in testbench module
            $timeformat(-9, 1, " ns", 9);
            #(1_000 * CLKCYCLE); // To avoid generating huge VCD files
            $display("[Time: %t] testbench timeout reached. Ending simulation.", $time);
            $finish;
        end
        else begin
            // $timeformat(-9, 1, " ns", 9);
            // #(20_000_000 * CLKCYCLE);
            // $display("[Time: %t] testbench timeout reached. Ending simulation.", $time);
            // $finish;
        end
    end

    // ========================================================================
    // Always blocks
    // ========================================================================
    // pipe j_rdata_i
    always_ff @(posedge clk_i or negedge rst_ni) begin
        if (!rst_ni) begin
            j_rdata_i <= 'd0;
        end else begin
            j_rdata_i <= j_rdata_latched;
        end
    end
    assign h_rdata_i = hbias_in_reg;
    // dly of debug en
    always_ff @(posedge clk_i or negedge rst_ni) begin
        if (!rst_ni) begin
            debug_j_write_en_dly1 <= 1'b0;
            debug_j_read_en_dly1 <= 1'b0;
            debug_spin_write_en_dly1 <= 1'b0;
            debug_spin_read_en_dly1 <= 1'b0;
            debug_spin_compute_en_dly1 <= 1'b0;
        end else begin
            debug_j_write_en_dly1 <= debug_j_write_en_i;
            debug_j_read_en_dly1 <= debug_j_read_en_i;
            debug_spin_write_en_dly1 <= debug_spin_write_en_i;
            debug_spin_read_en_dly1 <= debug_spin_read_en_i;
            debug_spin_compute_en_dly1 <= debug_spin_compute_en_i;
        end
    end

    // ========================================================================
    // Tasks
    // ========================================================================
    // Task for AW config interface
    task automatic aw_config_interface();
        config_aw_done = 0;
        analog_wrap_configure_enable_i = 0;
        cfg_trans_num_i = 'd0;
        cycle_per_wwl_high_i = 'd0;
        cycle_per_wwl_low_i = 'd0;
        cycle_per_spin_write_i = 'd0;
        cycle_per_spin_compute_i = 'd0;
        synchronizer_pipe_num_i = 'd0;
        synchronizer_wbl_pipe_num_i = 'd0;
        spin_wwl_strobe_i = 'd0;
        spin_feedback_i = 'd0;
        // Apply configuration
        wait (rst_ni == 1 && en_i == 1);
        @(negedge clk_i);
        $display("[Time: %t] AW configuration starts.", $time);
        analog_wrap_configure_enable_i = 1;
        cfg_trans_num_i = NUM_SPIN/PARALLELISM-1+1; // total transfer number (j + h)
        cycle_per_wwl_high_i = CyclePerWwlHigh - 1;
        cycle_per_wwl_low_i = CyclePerWwlLow - 1;
        cycle_per_spin_write_i = CyclePerSpinWrite - 1;
        cycle_per_spin_compute_i = CyclePerSpinCompute - 1;
        synchronizer_pipe_num_i = SynchronizerPipeNum;
        synchronizer_wbl_pipe_num_i = SynchronizerPipeNum;
        spin_wwl_strobe_i = SpinWwlStrobe;
        spin_feedback_i = SpinFeedback;
        @(negedge clk_i);
        analog_wrap_configure_enable_i = 0;
        config_aw_done = 1;
        $display("[Time: %t] AW configuration finished.", $time);
    endtask

    // Task for galena config
    task automatic galena_config_interface();
        wait (rst_ni == 0);
        config_galena_done = 0;
        dt_cfg_enable_i = 0;
        onloading_test_idx = 0;
        wait (rst_ni == 1 && en_i == 1 && config_aw_done == 1);
        @(negedge clk_i);
        while (onloading_test_idx < OnloadingTestNum) begin
            if (`DBG)
                $display("[Time: %t] Galena configuration testcase %0d starts.", $time, onloading_test_idx);
            @(negedge clk_i);
            dt_cfg_enable_i = 1;
            @(negedge clk_i);
            dt_cfg_enable_i = 0;
            wait (dt_cfg_idle_o == 1);
            onloading_test_idx = onloading_test_idx + 1;
            repeat ($urandom_range(0, 20)) @(negedge clk_i);
        end
        config_galena_done = 1;
    endtask

    // Task for h generation
    task automatic generate_hbias_input();
        integer spin_idx;
        logic signed [BITDATA-1:0] temp_hbias;
        hbias_in_reg = 'd0;
        wait (rst_ni == 1 && en_i == 1);
        forever begin
            @(negedge clk_i);
            for (spin_idx = 0; spin_idx < NUM_SPIN; spin_idx = spin_idx + 1) begin
                do begin
                    if (RANDOM_DATA == 1) begin
                        temp_hbias = $urandom_range(-2**(BITDATA-1), 2**(BITDATA-1) - 1);
                    end else begin
                        temp_hbias = FIXED_DATA;
                    end
                end while (temp_hbias == {1'b1, {BITDATA-1{1'b0}}});  // Exclude unsupported most negative value
                hbias_in_reg[spin_idx*BITDATA +: BITDATA] = temp_hbias;
            end
            wait (dt_cfg_enable_i == 1); // to avoid changing hbias continuously during idle
            @(negedge clk_i);
            wait (dt_cfg_idle_o == 1);
        end
    endtask
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
