KULeuven-MICAS/lagd-im/(commit log)

2025-08-20 improved unit test flow
    1. more significant example
    2. improved questasim defines
2025-09-25 finish lagd_soc.sv (6)
    1/6 create lags_mem_pkg
    2/6 fix name convention in lagd_pkg
    3/6 add spm and ising cores to lagd_soc
    4/6 removed mem blocks from config file
    5/6 fix naming convention in lagd_config
    6/6 minor ref add to lagd_typedef
    [lagd_pkg.sv, lagd_soc.sv]
2025-09-26 fix an incorrect signed interprectation for the adder tree
    [adder_tree.sv]
2025-09-26 fix the sign extension issue for the energy calc module
    [partial_energy_calc.sv]
2025-09-29 update the logic to use current_spin without spin mask
2025-09-29 clean the syntax mistake
    [accumulator.sv, energy_monitor.sv, logic_ctrl.sv, partial_energy_calc.sv, step_counter.sv]
2025-09-29 clean the port width mismatch mistake
    [partial_energy_calc.sv]
2025-09-29 disable the assertion as it does not work correctly
    [partial_energy_calc.sv]
2025-09-30 remove counter overflow signal; dly counter ready for 1 cycle to correct the energy_valid timing
    [energy_monitor.sv, step_counter.sv, tb_energy_monitor.sv]
2025-09-30 fix the energy monitor tb without pipes
    [tb_energy_monitor.sv]
2025-10-02 init commit synthesis flow (7)
    1/7 add config.tcl to config synthesis run
    2/7 add target for generating SRAMs from top level syn/Makefile
    3/7 add tsmc7ff-setup
    4/7 add ip and pad setup
    5/7 add mem macro setup
    6/7 add lib2db lc shell compiler
    7/7 add util scripts
2025-10-02 finish sram gen flow - to be tested
2025-10-08 correct the bandwidth of data_i
    [accumulator.sv]
2025-10-08 switch to use FFLARNC in accumulator
2025-10-08 update the logic ctrl; to be fixed
    [energy_monitor.sv, logic_ctrl.sv, step_counter.sv, tb_energy_monitor.sv]
2025-10-12 fix the energy monitor state machine and tb
    [logic_ctrl.sv, tb_energy_monitor.sv]
2025-10-30 fix sintax error on lagd_slv_idx_e definition
    [lagd_pkg.sv]
2025-10-30 fix multiple sintax errors
    [lagd_pkg.sv]
2025-10-31 fix sintax errors in lagd_soc
    [lagd_soc.sv]
2025-10-31 fix mistake in axi type definition
    [lagd_soc.sv]
2025-11-01 fix names in istance
    [lagd_soc.sv]
2025-11-01 minor fix on synthesis flow
2025-11-03 minor fix to avoid manual setting of temperature and voltage
2025-11-03 revert fixes on configurability of voltage and temperature
2025-11-07 minor fix in wire declaration
    [memory_island_wrap.sv]
2025-11-12 fix minor mistake in lagd_pkg.sv
    [lagd_pkg.sv]
2025-11-13 fix memory island instantiation in lagd_soc
    [lagd_soc.sv]
2025-11-21 fix small sintax error
    [wide_narrow_arbiter.sv]
2025-11-21 fix unsynth error for not automatic function in memory_island_pkg
    [memory_island_pkg.sv]
2025-11-21 fix naming in top level file
    [memory_island_wrap.sv]
2025-11-21 fix syntax errors in lagd_mem_cfg_pkg
    [lagd_mem_cfg_pkg.sv]
2025-11-21 fix inconsistency of configuration name RW calls in memory_island_wrap
    [memory_island_wrap.sv]
2025-11-21 fix other name incosistencies in memory_island_wrap
    [memory_island_wrap.sv]
2025-11-21 fix bad hierachical name in axi_to_mem_adapter
    [axi_to_mem_adapter.sv]
2025-11-21 fix nameing in memory_sland_core
    [memory_island_core.sv]
2025-11-21 fix attempt to bad hierachical name in axi_to_mem_adapter.sv
    [axi_to_mem_adapter.sv]
2025-11-21 add separate memories for J, h, flip
    [ising_core_wrap.sv, lagd_soc.sv]
2025-11-22 correct genblock with always_comb
    [memory_island_core.sv]
2025-11-22 fix localparam with automatic local variables
    [memory_island_core.sv]
2025-11-22 fix sintax errors in leaf modules
    [axi_to_mem_adapter.sv, memory_island_core.sv, tcdm_interconnect_wrap.sv, wide_narrow_arbiter.sv]
2025-11-25 fix a few address incoherency
    [memory_island_core.sv, tcdm_interconnect_wrap.sv, wide_to_narrow_splitter.sv]
2025-11-25 add first version of flip manager
    [energy_fifo_maintainer.sv, flip_engine.sv, flip_manager.sv, spin_fifo_maintainer.sv]
2025-11-25 add first testbench for flip_manager
    [tb_flip_manager.sv]
2025-11-26 fix syntax errors in memory_island_core
    [memory_island_core.sv]
2025-11-26 fix some width mismatch and add debug info
    [axi_to_mem_adapter.sv, memory_island_core.sv, tcdm_interconnect_wrap.sv, wide_narrow_arbiter.sv]
2025-11-26 minimal fix on extra $
    [wide_narrow_arbiter.sv]
2025-11-26 fix address width mismatch in axi_to_mem adapter declaration
    [lagd_mem_cfg_pkg.sv, memory_island_wrap.sv, tcdm_interconnect_wrap.sv]
2025-11-26 attempt to fix address incongruencies redefiniling parameters
    [memory_island_core.sv, memory_island_wrap.sv]
2025-11-26 fix minor sintax mistake
    [memory_island_core.sv]
2025-11-26 fix I-O addr width mismatch in tcdm instance
    [memory_island_core.sv, tcdm_interconnect_wrap.sv]
2025-11-26 fix mistake in output address width
    [memory_island_core.sv]
2025-11-26 fix number of banks in cfgs
    [lagd_mem_cfg_pkg.sv]
2025-11-26 add missing ; -.-
    [memory_island_core.sv]
2025-11-26 fix typo in parameter definition
    [ising_core_wrap.sv]
2025-11-26 fix the counter overflow logic
    [step_counter.sv]
2025-11-28 fix conding style in mem_cfg_pkg
    [lagd_mem_cfg_pkg.sv]
2025-11-28 fix type name in ising core isntance
    [lagd_soc.sv]
2025-11-28 use bp_pipe to replace FFL
    [adder_tree.sv, energy_monitor.sv, partial_energy_calc.sv]
2025-11-29 fix direction of multicut rsp in memory_island_wrap.sv
    [memory_island_wrap.sv]
2025-12-01 fix a warning due to bandwidth difference
    [partial_energy_calc.sv]
2025-12-01 fix the basic control flow
    [energy_fifo_maintainer.sv, flip_engine.sv, flip_manager.sv, spin_fifo_maintainer.sv]
2025-12-01 fix the basic testbench
    [tb_flip_manager.sv]
2025-12-01 fix the control path timing on spin_pop_valid_o when icon run out
    [flip_manager.sv, spin_fifo_maintainer.sv, tb_flip_manager.sv]
2025-12-02 fix timing in tb
    [tb_flip_manager.sv]
2025-12-02 fix a typo in lagd_soc
    [lagd_soc.sv]
2025-12-03 removed SPI host
2025-12-03 add axi master typedef and declaration/attachment
2025-12-03 integrate spi slave
2025-12-03 fix bender lock and first sintax error
    [lagd_pkg.sv]
2025-12-03 fix data width for wide
    [lagd_soc.sv]
2025-12-03 fix port declaration in cheshire
    [lagd_soc.sv]
2025-12-03 fix sintax errors and add axi_spi_slave to Bender.yml
    [lagd_axi_spi_slave.sv]
2025-12-03 fix axi types in spi slaves
    [lagd_soc.sv]
2025-12-03 fix sintax mistake in axi_spi_slave
    [lagd_axi_spi_slave.sv]
2025-12-04 fix the port width mismatch problem
    [digital_macro.sv, energy_monitor.sv, partial_energy_calc.sv, tb_digital_macro.sv, tb_energy_monitor.sv]
2025-12-05 move all simulation generated files under ${SIM_TOOL}-runs directory (8)
    1/8) made clean SIM_TOOL dependent
    2/8) minor fix in .gitignore
    3/8) add WORK_DIR along side TEST_PATH
    4/8) add configurability of VCD_FILE in SV tbs
    5/8) vsim/build.tcl moves .in file
    6/8) add WORK_DIR and VCD_FILE to defines.tcl
    7/8) add WORK_DIR in vsim/sim-run.tcl
    8/8) refactor vsim.mk
    [tb_adder.sv]
2025-12-08 fix syntax error in ising_core_wrap
    [ising_core_wrap.sv]
2025-12-09 correct the parameter types in ising_core_wrap
    [ising_core_wrap.sv]
2025-12-09 fix compilation syntax error
    [logic_ctrl.sv, step_counter.sv]
2025-12-09 fix synthesis syntax error in energy_fifo_maintainer
    [energy_fifo_maintainer.sv]
2025-12-09 fix compilation syntax error in spin_fifo
    [spin_fifo_maintainer.sv]
2025-12-09 add instance name axi_spi_slave to avoid synthesis warning
    [lagd_axi_spi_slave.sv]
2025-12-09 fix synthesis compilation error
    [analog_cfg.sv]
2025-12-09 fix synthesis syntax error
    [analog_rx.sv, analog_tx.sv]
2025-12-09 fix a typo on q.user
    [ising_core_wrap.sv]
2025-12-10 move lagd_fifo_v3 to flip_manager folder
    [energy_fifo_maintainer.sv, lagd_fifo_v3.sv, spin_fifo_maintainer.sv]
2025-12-10 fix port width mismatch of sfc_rdata in ising_core_wrap
    [ising_core_wrap.sv]
2025-12-10 try to fix the xbar port connection in ising_core
    [ising_core_wrap.sv]
2025-12-10 correct j and flip mem addr width
    [ising_core_wrap.sv]
2025-12-10 correct flip addr width
    [ising_core_wrap.sv]
2025-12-10 correct sfc data width
    [ising_core_wrap.sv]
2025-12-10 add missing parameters for mem instances
    [ising_core_wrap.sv]
2025-12-10 try to fix axi type; not sure it works
    [ising_core_wrap.sv]
2025-12-11 revert back to info
    [ising_core_wrap.sv]
2025-12-11 add a missing logic define
    [energy_monitor.sv]
2025-12-11 update galena pin according to lib
2025-12-11 fix the port mismatch related to galena
    [ising_core_wrap.sv]
2025-12-11 update j/flip mem spec
    [lagd_mem_cfg_pkg.sv]
2025-12-11 scale up j/flip mem size as words per bank can only be 2048
    [lagd_mem_cfg_pkg.sv]
2025-12-12 lint fix, trail 2
    [lagd_fifo_v3.sv]
2025-12-15 set correct depth for l1 memories
    [lagd_mem_cfg_pkg.sv]
2025-12-15 moved tcdm corner case handle inside the tcdm
2025-12-15 fix mistake in tcdm interconnect
    [tcdm_interconnect_wrap.sv]
2025-12-15 fix wrong include paths
    [accumulator.sv, adder_tree.sv, analog_cfg.sv, analog_rx.sv, analog_tx.sv, digital_macro.sv, energy_fifo_maintainer.sv, energy_monitor.sv]
2025-12-15 fix byte enable and make ising cores equal to 2
    [lagd_mem_cfg_pkg.sv, memory_island_core.sv, tcdm_interconnect_wrap.sv]
2025-12-16 update every tb to match current sim flow
2025-12-19 support para parsing defined in bender exec in flist
2025-12-22 clock gate flip_ren reg when flip is disabled
    [flip_engine.sv]
2025-12-22 Correct on the one-hot wwl check
    [tb_digital_macro.sv]
2025-12-23 Rename DATASPIN to NUM_SPIN for flip manager
    [energy_fifo_maintainer.sv, flip_engine.sv, flip_manager.sv, spin_fifo_maintainer.sv, tb_flip_manager.sv]
2025-12-24 Simple galena onloading case verified
2025-12-24 reference model improvement: avoid h_reg extra change; add random delay between onloading tests
    [tb_analog_macro_wrap.sv]
2025-12-24 fix entire analog wrap
    [analog_rx.sv, analog_tx.sv, tb_analog_macro_wrap.sv]
2025-12-31 add dry_run option for elaboration only case
2025-12-31 fix sintax error in axi_to_mem_adapter.sv
    [axi_to_mem_adapter.sv]
2026-01-05 axi_to_mem_adapter tb compiles (6)
    1/6 add common_verification to Bender.yml
    2/6 add sim flags to bender flist generation
    3/6 fix sintax errors in tb_common
    4/6 fix sintax errors in tb_axi_to_mem
    5/6 add extra files and include in the flist for axi_to_mem
    6/6 minor addition in the build.tcl
    [tb_axi_to_mem_adapter.sv]
2026-01-05 fix simulation for axi_to_mem_adapter
    [tb_axi_to_mem_adapter.sv]
2026-01-06 minor fix on axi_to_mem_adapter
    [axi_to_mem_adapter.sv, memory_island_wrap.sv, tb_axi_to_mem_adapter.sv]
2026-01-06 finish verifying flip manager function
    [energy_fifo_maintainer.sv, flip_engine.sv, flip_manager.sv, tb_flip_manager.sv]
2026-01-08 fix multidriven port mistake
    [mem_multicut.sv, mem_rsp_multicut.sv]
2026-01-09 expose energy fifo register to the flip manager interface
    [energy_fifo_maintainer.sv, lagd_fifo_v3.sv, spin_fifo_maintainer.sv, tb_flip_manager.sv]
2026-01-09 add ports to the flip manager top
    [flip_manager.sv]
2026-01-09 update case num in analog macro wrap tb
2026-01-09 fix the timing when icon runs out
    [flip_engine.sv]
2026-01-09 correct the flush condition of spin_push_none reg
    [energy_fifo_maintainer.sv]
2026-01-09 remove the en_i gating at submodule inputs so that switching en_i=0 does not stop receiving new inputs
2026-01-09 update the flip manager tb to support odd number of FLIP_ICON_DEPTH
    [tb_flip_manager.sv]
2026-01-09 all tb run correctly
    [mem_seq_generator.sv, tb_tcdm_interconnect_wrap.sv]
2026-01-09 minor bug fix in memory_island_core
    [memory_island_core.sv]
2026-01-13 fix a hidden bug on wbl_spin_expanded in analog wrap
    [analog_macro_wrap.sv]
2026-01-13 recover the commented timer in analog wrap tb
2026-01-14 remove wide splitter in the case wide port matches narrow port
2026-01-14 fix a timing issue in a task of the analog wrap tb
    [tb_analog_macro_wrap.sv]
2026-01-14 fix minor sintax problems across memory island
    [memory_island_core.sv, memory_island_wrap.sv]
2026-01-14 fix the bug that synchronization starts incorrectly when en_i=0
    [analog_rx.sv]
2026-01-15 rename a signal in flip manager
    [flip_manager.sv]
2026-01-16 fix sintax/structural mistakes in arbiter and memory_core
    [memory_island_core.sv, wide_narrow_arbiter.sv]
2026-01-16 fix a bug in energy monitor that hbias is mapped corrently when PARALLELLISM > 1
    [energy_monitor.sv, tb_energy_monitor.sv]
2026-01-16 Correct the spin connection from fm to em when analog is disabled
    [digital_macro.sv]
2026-01-18 correct the logic of signal maxed_o in step_counter
    [step_counter.sv]
2026-01-19 fix minor double drive in wide port wide_narrow_arbiter
    [wide_narrow_arbiter.sv]
2026-01-19 minor fixes in stim generation
    [axi_rand_stim_gen.sv, mem_seq_stim_gen.sv]
2026-01-19 add two extra debugging ports to flip manager
    [flip_manager.sv, tb_flip_manager.sv]
2026-01-19 fix addressing in wide memory port
    [tcdm_interconnect_wrap.sv, wide_to_narrow_splitter.sv]
2026-01-19 fix the port width mismatch in partial energy calc after scaling h by 2
    [partial_energy_calc.sv]
2026-01-22 add flip_filter to enable the new feature of energy calculation
    [dgt_raddr_manager.sv, digital_macro.sv, flip_filter.sv, mem_to_handshake_fifo.sv, tb_digital_macro.sv]
2026-01-22 fix mismatch between J and Flip data memories
    [ising_core_wrap.sv, lagd_soc.sv]
2026-01-22 update flip_manager so that it runs one cycle when flip_disable_i is enabled
    [flip_engine.sv, flip_manager.sv]
2026-01-22 add the enable_flip_detection_i to input of flip filter
    [flip_filter.sv]
2026-01-22 move flip filter module to a separate folder
    [dgt_raddr_manager.sv, flip_filter.sv]
2026-01-25 reduce the default test case amount of analog macro wrap so it finishes faster
2026-01-26 fix the debug-data writing mode for analog macro wrap
    [analog_macro_wrap.sv, tb_analog_macro_wrap.sv]
2026-01-26 fix the debug-data reading mode for analog macro wrap
    [analog_dt_debug.sv, analog_macro_wrap.sv, analog_tx.sv, tb_analog_macro_wrap.sv]
2026-01-27 extend simulation flow to accept custom flags from user specific Makefiles
2026-01-27 fix build.tcl in case compilation is done in the hdl_file_list
2026-01-27 declare two inputs as wire to avoid warning in simulation
    [flip_filter.sv]
2026-01-28 minor fix in testbench
    [fixture_lagd_chip.sv, lagd_axi_spi_slave.sv]
2026-01-28 fix a typo in arbiter naming
    [customized_arbiter.sv, dgt_raddr_manager.sv]
2026-01-28 change case to generic logic in analog_cfg
2026-01-28 change flip_raddr_o to one bit less
    [digital_macro.sv, tb_digital_macro.sv]
2026-01-29 improve simulation flow
2026-01-29 minor fixes for system level testbench
    [tb_lagd_chip.sv]
2026-01-29 address a syn syntax error in flip engine
    [flip_engine.sv]
2026-01-29 add missing instance name to synchronizer
    [synchronizer.sv]
2026-01-29 add missing logics in analog debug
    [analog_dt_debug.sv, analog_spin_debug.sv]
2026-01-29 remove a redundent case condition in em
2026-01-29 fix again the analog format translation formula
    [analog_cfg.sv, tb_analog_macro_wrap.sv]
2026-01-30 fix typos in reggen hjson and lagd core wrap
    [ising_core_wrap.sv]
2026-02-03 add bootrom linker script and build flow
2026-02-03 fix the timing in tb_ising_core_wrap
    [tb_ising_core_wrap.sv]
2026-02-03 add a missing debug connection in digital macro
    [digital_macro.sv]
2026-02-03 fix a syntax in ising_core_wrap
    [ising_core_wrap.sv]
2026-02-04 add infinite_icon_loop_en_i to flip manager for power measurement purpose
    [config_pkg.sv, digital_macro.sv, flip_engine.sv, flip_manager.sv, ising_core_wrap.sv, tb_digital_macro.sv, tb_flip_manager.sv, tb_ising_core_wrap.sv]
2026-02-05 fix a syntax error in lagd_pkg
    [lagd_pkg.sv]
2026-02-08 add makefile flow for generating syntehsis files
2026-02-10 fix a synthesis error
    [digital_macro.sv]
2026-02-10 reset a parameter in flip manager tb
    [tb_flip_manager.sv]
2026-02-10 fix a typo in comments
    [config_spin_ctrl.sv]
2026-02-10 fix typos for digital macro tb
    [tb_digital_macro.sv]
2026-02-10 change the default case num for random test of energy monitor
2026-02-10 add missing flush_i to adder tree
    [adder_tree.sv, partial_energy_calc.sv]
2026-02-10 add missing flush_i to energy fifo and flip engine
    [energy_fifo_maintainer.sv, flip_engine.sv]
2026-02-10 fix digital macro tb when FlipDisable is 1
    [tb_digital_macro.sv]
2026-02-10 fix a small problem in digital macro tb
    [tb_digital_macro.sv]
2026-02-12 fix a bug in j memory mux in ising_core_wrap
    [ising_core_wrap.sv]
2026-02-12 fixes on the memory_island testbench
    [tb_memory_island.sv]
2026-02-12 change the default FlipDisable value of digital macro tb
    [tb_digital_macro.sv]
2026-02-12 add correct booting sequence for ising_core_wrap tb
    [tb_ising_core_wrap.sv]
2026-02-12 add a missing ()
    [tb_ising_core_wrap.sv]
2026-02-13 change the missed parameter name in last commit
    [galena_pkg.sv]
2026-02-13 fix a few comments
    [galena.sv, galena_pkg.sv]
2026-02-13 fix two small formating issues
    [galena.sv, tb_analog_model.sv]
2026-02-13 fix spin_cache behavior and add an assert
    [galena.sv, galena_pkg.sv]
2026-02-15 fix the perf counter behavior under infinite_icon_loop_en
    [digital_macro.sv]
2026-02-15 fix the updating logic of fifo update reg
    [ising_core_wrap.sv]
2026-02-16 fix runtime assert and add include dirs in tb_hdl_file_list
    [accumulator.sv, galena.sv]
2026-02-16 chip test is now passed to fixture from tb_lagd_chip.sv
    [fixture_lagd_chip.sv, tb_lagd_chip.sv]
2026-02-16 sintax fix on localparam meant to be param
    [fixture_lagd_chip.sv]
2026-02-16 fix port mismatch for lagd_chip in fixture_lagd_chip.sv
    [fixture_lagd_chip.sv]
2026-02-17 fix bug in case VLOG_FLAGS is set
2026-02-17 fix port connection and type for chip level verification
    [fixture_lagd_chip.sv]
2026-02-17 assign or tie inputs to signals in fixture for the chip test case
    [fixture_lagd_chip.sv]
2026-02-17 extra fixes in fixture
    [fixture_lagd_chip.sv]
2026-02-19 add timer to sys-run.sh
2026-02-19 add a timer to ising c program
2026-02-23 try to fix clang errors
    [lagd_reg_params.h]
2026-02-23 fixes: add more exception in pkg_bender_list generation and fix mistake in hdl_file_list in case of netlist test
2026-02-23 tentative fixes in memory island
    [axi_to_mem_adapter.sv, lagd_soc.sv, mem_rsp_multicut.sv, memory_island_core.sv, wide_narrow_arbiter.sv]
2026-02-23 fix the l1 memory address map
    [lagd_pkg.sv]
2026-02-23 SPI slave updated
2026-02-23 fix the default value for analog csr
    [lagd_reg_params.h]
2026-02-24 fixes on ising_core_wrap and tb
    [ising_core_wrap.sv, lagd_soc.sv, tb_ising_core_wrap.sv]
2026-02-24 add dbg signals in spi
2026-02-24 attempt fix on spi
    [fixture_lagd_chip.sv, spi_test_lib.sv, tb_lagd_chip.sv]
2026-02-24 add latest fixes to fixture_lagd_chip.sv
    [fixture_lagd_chip.sv]
2026-02-25 add debug prints and asserts on pomelo_pll model
2026-02-25 fix the default value of reg wbl_floating
    [galena.sv]
2026-02-25 fix a path def in galena behavior model
    [galena.sv]
2026-02-25 fix the default wbl_floating_o of analog_macro_wrap
    [analog_macro_wrap.sv]
2026-02-26 add printf to lagd_reg_cfg.h
2026-02-26 fix pomelo model if: inout to proper direction
    [pomelo_pll.sv]
2026-02-26 update a print in digital_macro tb
2026-02-26 minor fix in the pomelo_pll model
    [pomelo_pll.sv]
2026-02-26 fix system level tb
    [tb_lagd_chip.sv]
2026-02-26 add the missing debug_wbl_config to ising_core_wrap
    [ising_core_wrap.sv]
2026-02-27 add extreme data case for power analysis
2026-02-27 add flip_raddr_l7b to csr
    [config_pkg.sv, ising_core_wrap.sv]
2026-03-01 clang format fix 1
    [lagd_common.h, lagd_debug_dt.spm.c, lagd_debug_spin.spm.c]
2026-03-01 clang format fix 2
    [lagd_common.h, lagd_scompute.spm.c]
2026-03-01 clang format fix 3
    [lagd_common.h]
2026-03-01 clang format fix 4
    [lagd_common.h, lagd_debug_dt.spm.c]
2026-03-01 clang format fix 5
    [lagd_common.h]
2026-03-01 variable scope fix on scompute c
    [lagd_scompute.spm.c]
2026-03-01 fix write behavior of galena model
    [galena.sv]
2026-03-01 fix galena model read behavior
    [galena.sv]
2026-03-01 fix sys-run.sh flow
2026-03-02 fix a mux cond in ising_core_wrap
    [ising_core_wrap.sv]
2026-03-02 fix a typo in dcompute
    [lagd_dcompute.spm.c]
2026-03-03 improve vcd dump flow
2026-03-18 fix frequencies on tb
    [fixture_lagd_chip.sv]
2026-03-19 minor fix in fixture_lagd_chip
    [fixture_lagd_chip.sv]
2026-03-19 make SPI test more sturdy for timing aware simulation
2026-04-23 add delays to spi test to prevent race conditions in SDF tests
    [spi_test_lib.sv]
2026-07-28 fix: changes for multi-core compilation
    [lagd_common.h, lagd_dcompute.spm.c, lagd_scompute.spm.c]
2026-07-28 fix: ruff fixes and added new author
    [lagd_common.h, lagd_dcompute.spm.c, lagd_scompute.spm.c]
2026-07-29 correct the file definition of tb_ising_core_wrap.sv
    [tb_ising_core_wrap.sv]
2026-07-30 fix galena parameter pass
    [galena.sv, galena_pkg.sv]
2026-07-31 fix the lagd_debug_dt c program
    [lagd_debug_dt.spm.c]
2026-07-31 fix the lagd_debug_spin and add print cap to lagd_debug_dt/spin
    [lagd_common.h, lagd_debug_dt.spm.c, lagd_debug_spin.spm.c]
2026-07-31 remove a print from lagd_common
2026-09-05 Create new lagd_scompute_debug.spm.c (#35)
    * create lagd_scompute_debug.spm.c
    * update sw/makefile
    * add decimal print in lagd_print_energy_fifo_data
    * lint fix
    * add lagd_debug_load.h
    * update sw/makefile and remove outdated comment
    * lint fix
    * add the counter to lagd_scompute_debug.spm.c
    ---------
    [lagd_common.h, lagd_debug_load.h, lagd_scompute_debug.spm.c]
